Wren6991/GuitarPedal/Guitar Pedal.odt

Guitar Pedal

Input: 6.3mm guitar jack, 3.5mm aux in (capacitively coupled together)

Output: 6.3mm guitar jack, plus 3.5mm headphone jack (common connections) for playing without amp.

Some sort of Cortex-M4F etc with an ADC and a DAC. 12 bits MINIMUM.

Suck data out of ADC with DMA or interrupt into a buffer.

When this buffer is full, flip output buffer and start a new effects process into the output back buffer.

This means 3 buffers: input, output backbuffer, and output DAC buffer.

We will also need at least this buffer size to compute an FFT.

This means, for 24kiB of ram, we have < 6kiB of sample space.

We want at least 20kSa/s to get good guitar sound (highest note on a guitar is ~1.3kHz, but at this point most amps will be playing a sine wave. Realistically we don't need more than 6kHz bandwidth.)

We want to keep effects delay to a minimum – ideally < 10ms. If we pick 25.6 kSa/s, we get 256 samples per buffer, which is a nice length for an FFT. This is 1kiB of RAM, for 32-bit floats. We can keep up to 1/5th second of history in a ring buffer, for delay effects.

Let's put a screen on it to show the current effect name etc.

A pair of big stomp switches on top (arcade machine), one at each end, programmable. A pair of pots, for input to the effect program. Some pin headers to connect external pots/pedals, switches. And maybe some smaller switches for the interface.

Effects consist of:

A function which takes pointers to the input buffer, the output front buffer (for delay effects) and the output back buffer for output and scratch space.

In general, an effect will:

- Fill the output back buffer with some function of each input sample (e.g. gain, soft distortion)
- Fill its FFT buffer with the FFT of this result
- Multiply the FFT with some frequency profile (tone controls, and e.g. moving passband for wah pedal)
- Put the IFFT into the back buffer.
- At 72MHz and 25.6kSa/s, we have almost 3000 cycles per sample.1

Runs off of a li po battery, regulated to 3v3 with an LDO. Charge with micro USB, with a lithium charger IC.

Software structure:

Effects can be stacked.

All audio processing takes place in one large ring buffer.

We know that the output from one effect is the input to another. So…

Each effect has a function pointer, and is allocated a certain number of consecutive blocks (e.g. 256 samples each) in the ring buffer. Blocks are arranged sequentially in the ring buffer. An effect like delay/reverb will have more blocks than one like distortion. ( Can we make distortion have 0 blocks instead of 1, by using the next effect's buffer? Try later.)

The blocks form the effect's input history. Each new frame, the base pointer for all blocks is advanced by one. The top block for each effect is now garbage, and the last block is dropped off the end (to become that garbage), but this is fine because the job of each effect is to generate a new top block for the next effect.

The special cases are the first effect in the stack, whose block0 is generated from the input DAC, and the final effect, which writes into the output back buffer instead of the next effect's block0.

We use the block + ring buffer because it is very easy and efficient to allocate each effect's buffer at runtime.

May be better to index the ring buffer with 0 being most recent, and positive values going into the past.
