Wren6991/GuitarPedal/board2.png

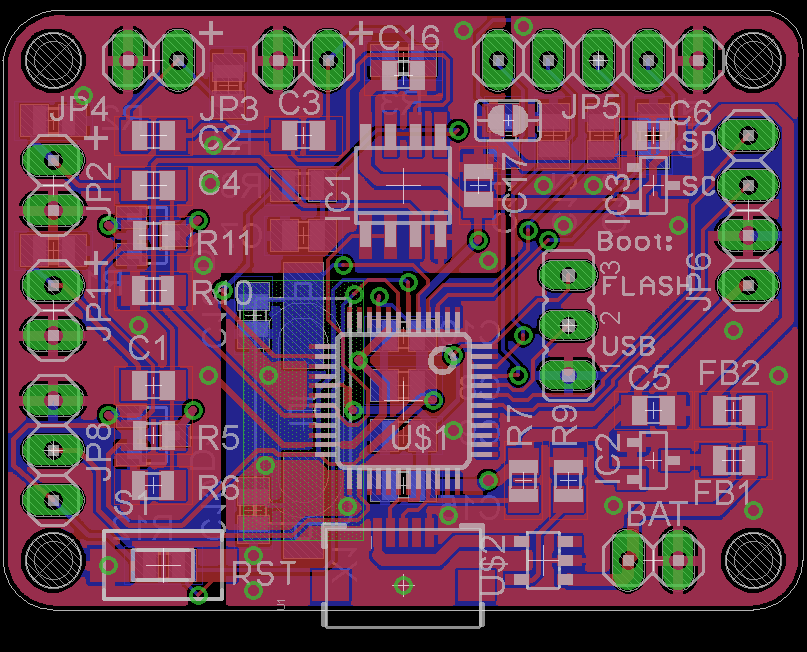
board2.png
