Wren6991/GuitarPedal/board.png

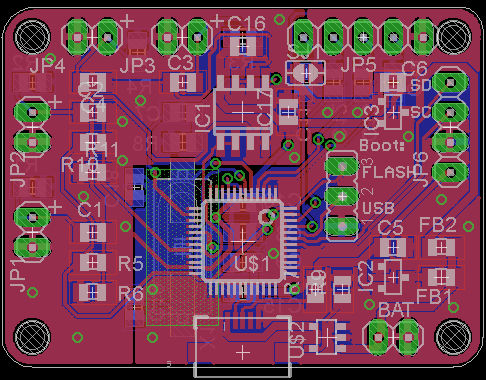
board.png
