Wren6991/GuitarPedal/processorboard.brd

## EAGLE design processorboard.brd (2015-11-23)

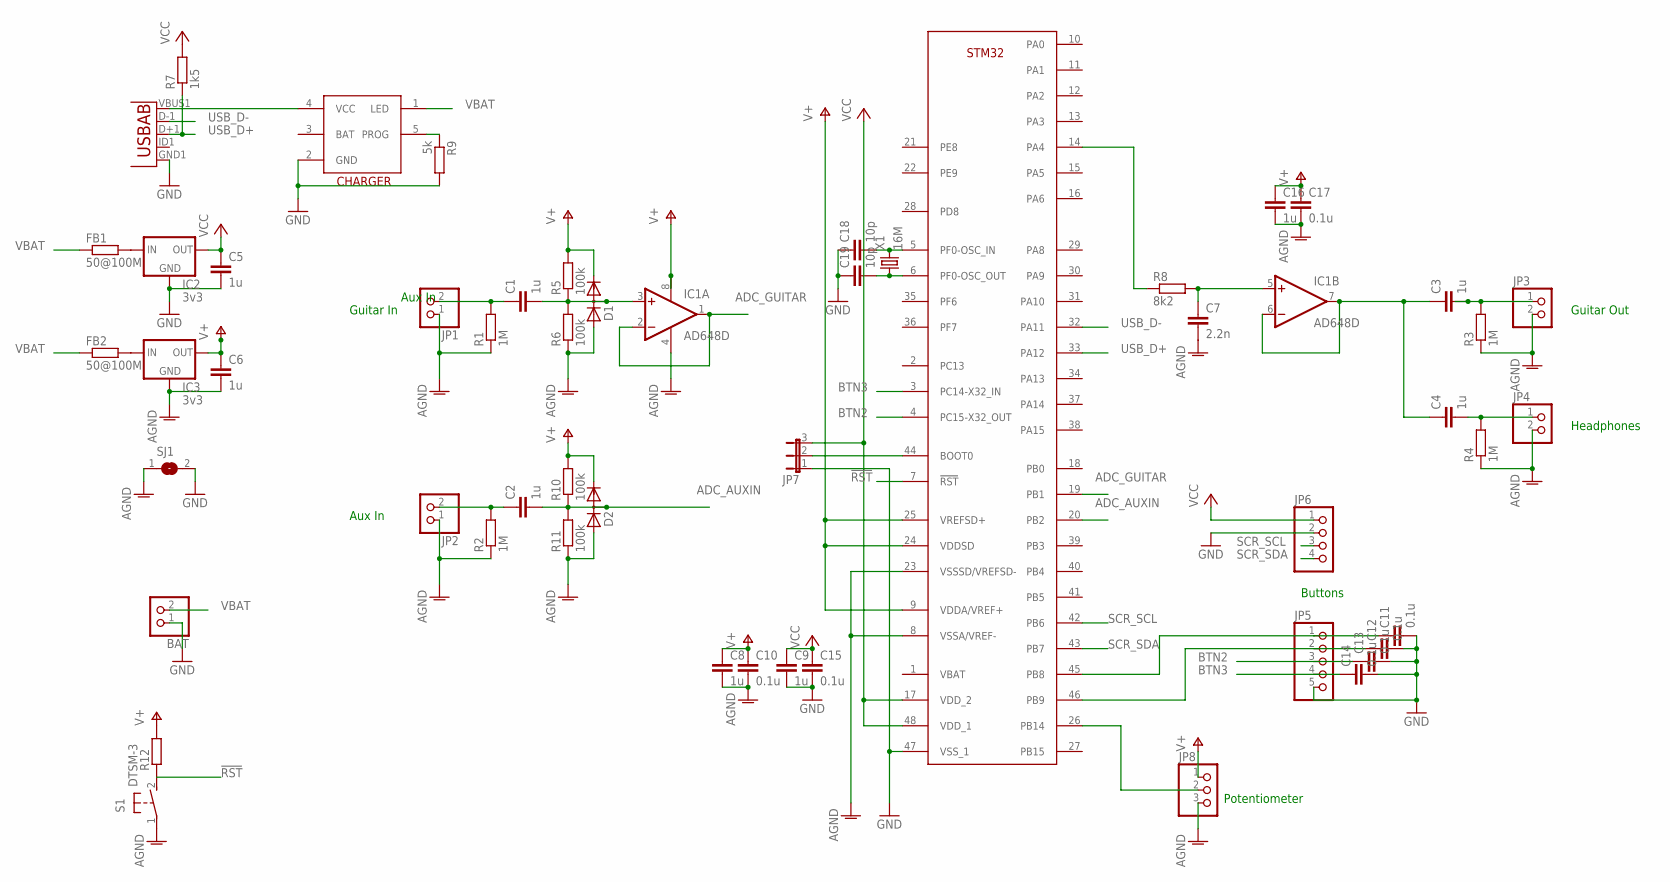
[picture p3: schematic processorboard.sch]

Parts:
BAT: PINHD-1X2; 1X02
C1, C2, C3, C4, C5, C6, C8, C9, C16: 1u; C0805
C7: 2.2n; C0805
C10, C11, C12, C13, C14, C15, C17: 0.1u; C0805
C18, C19: 10p; C0805
D1, D2: DIODE_2CACA-SOT23; SOT23
FB1, FB2: 50@100M; R0805
IC1: AD648D; SO08
IC2, IC3: 3v3; SOT23
JP1, JP2, JP3, JP4: PINHD-1X2; 1X02
JP5: PINHD-1X5; 1X05
JP6: PINHD-1X4; 1X04
JP7: JP2E; JP2
JP8: PINHD-1X3; 1X03
R1, R2, R3, R4: 1M; R0805
R5, R6, R10, R11: 100k; R0805
R7: 1k5; R0805
R8: 8k2; R0805
R9: 5k; R0805
R12: R-EU_R0805; R0805
S1: DTSM-3
SJ1: SJ
U1: USB""; USB-MICRO-SMD
U$1: STM32F373CBT6; LQFP48
U$2: LI_CHARGER; SOT23-5L
X1: 16M; HC49UP

Connections:
!RST: R12.1, S1.2, U$1.7 (!RST)
ADC_AUXIN: C2.2, D2.3 (AC), R10.1, R11.2, U$1.20 (PB2)
ADC_GUITAR: IC1.1 (OUT), IC1.2 (-IN), U$1.19 (PB1)
AGND: C6.2, C7.2, C8.2, C10.2, C16.2, C17.2, D1.1 (A), D2.1 (A), IC1.4 (V-), IC3.1 (GND), JP1.1, JP2.1, JP3.2, JP4.2, JP8.3, R1.1, R2.1, R3.1, R4.1, R6.1, R11.1, S1.1, SJ1.1, U$1.8 (VSSA/VREF-), U$1.23 (VSSSD/VREFSD-)
BTN0: C11.1, JP5.1, U$1.45 (PB8)
BTN1: C12.1, JP5.2, U$1.46 (PB9)
BTN2: C13.1, JP5.3, U$1.4 (PC15-X32_OUT)
BTN3: C14.1, JP5.4, U$1.3 (PC14-X32_IN)
DAC_GUITAR: R8.1, U$1.14 (PA4)
DAC_GUITAR_FILT: C7.1, IC1.5 (+IN), R8.2
GND: BAT.1, C5.2, C9.2, C11.2, C12.2, C13.2, C14.2, C15.2, C18.1, C19.1, IC2.1 (GND), JP5.5, JP6.2, JP7.1, R9.2, SJ1.2, U1.GND1 (GND), U$1.47 (VSS_1), U$2.2 (GND)
unnamed: C3.2, JP3.1, R3.2
unnamed: C4.2, JP4.1, R4.2
unnamed: C2.1, JP2.2, R2.2
unnamed: JP7.2, U$1.44 (BOOT0)
unnamed: C1.1, JP1.2, R1.2
unnamed: C1.2, D1.3 (AC), IC1.3 (+IN), R5.1, R6.2
unnamed: C19.2, U$1.6 (PF0-OSC_OUT), X1.1
unnamed: JP8.2, U$1.26 (PB14)
unnamed: FB1.2, IC2.3 (IN)
unnamed: C3.1, C4.1, IC1.6 (-IN), IC1.7 (OUT)
unnamed: R9.1, U$2.5 (PROG)
unnamed: FB2.2, IC3.3 (IN)
unnamed: C18.2, U$1.5 (PF0-OSC_IN), X1.2
SCR_SCL: JP6.3, U$1.42 (PB6)
SCR_SDA: JP6.4, U$1.43 (PB7)
USB_D+: R7.1, U1.D+1 (D+), U$1.33 (PA12)
USB_D-: U1.D-1 (D-), U$1.32 (PA11)
V+: C6.1, C8.1, C10.1, C16.1, C17.1, D1.2 (C), D2.2 (C), IC1.8 (V+), IC3.2 (OUT), JP8.1, R5.2, R10.2, R12.2, U$1.9 (VDDA/VREF+), U$1.24 (VDDSD), U$1.25 (VREFSD+)
VBAT: BAT.2, FB1.1, FB2.1, U$2.1 (LED)
VCC: C5.1, C9.1, C15.1, IC2.2 (OUT), JP6.1, JP7.3, R7.2, U$1.17 (VDD_2), U$1.48 (VDD_1)
VUSB: U1.VBUS1 (VBUS), U$2.4 (VCC)

Notes on the sheet:
Guitar In
Aux In
Guitar Out
Headphones
Buttons
Potentiometer

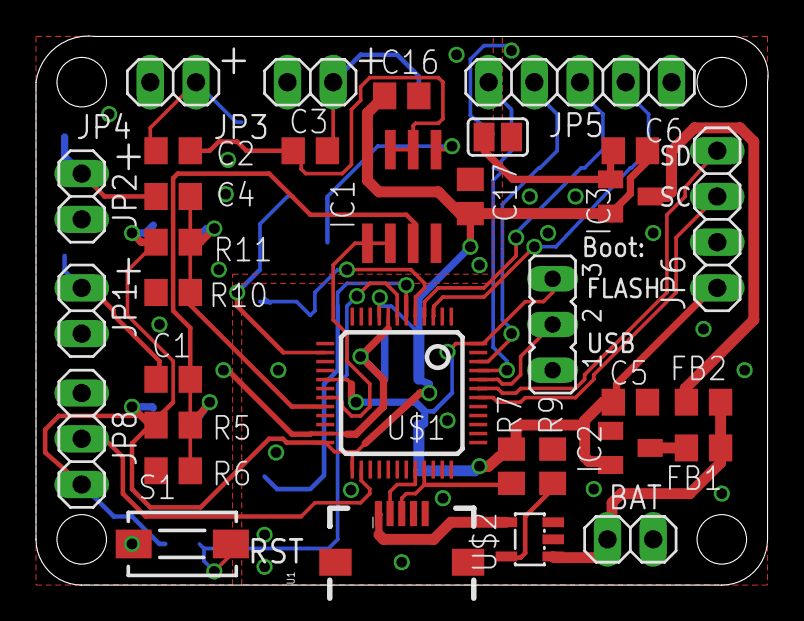
[picture p4: board processorboard.brd from above]

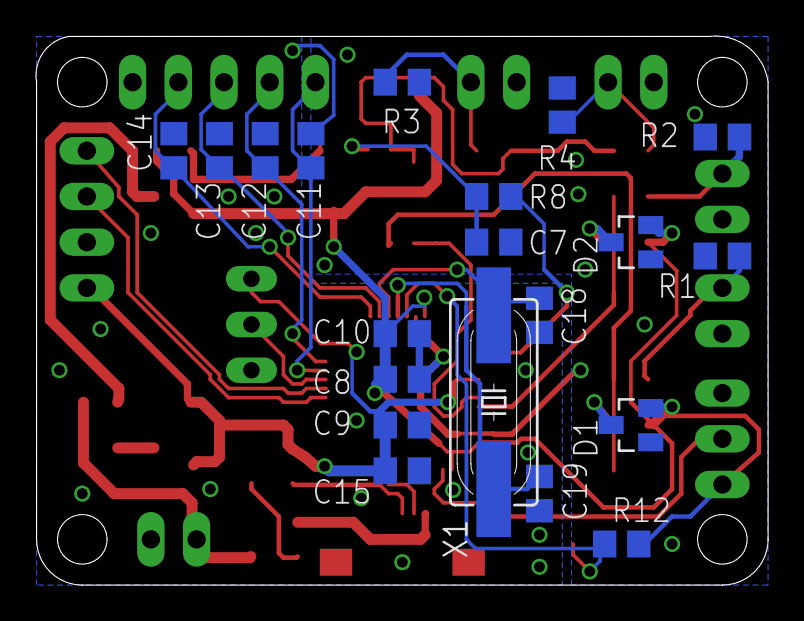
[picture p5: board processorboard.brd from below]

Board: 2 copper layers, 40.7 x 30.5 mm, 53 parts (20 on the bottom side), 32 nets.
